interactionresearchstudio/VisionCam_Lasercut_Hanger/Lasercut Hanger.pdf

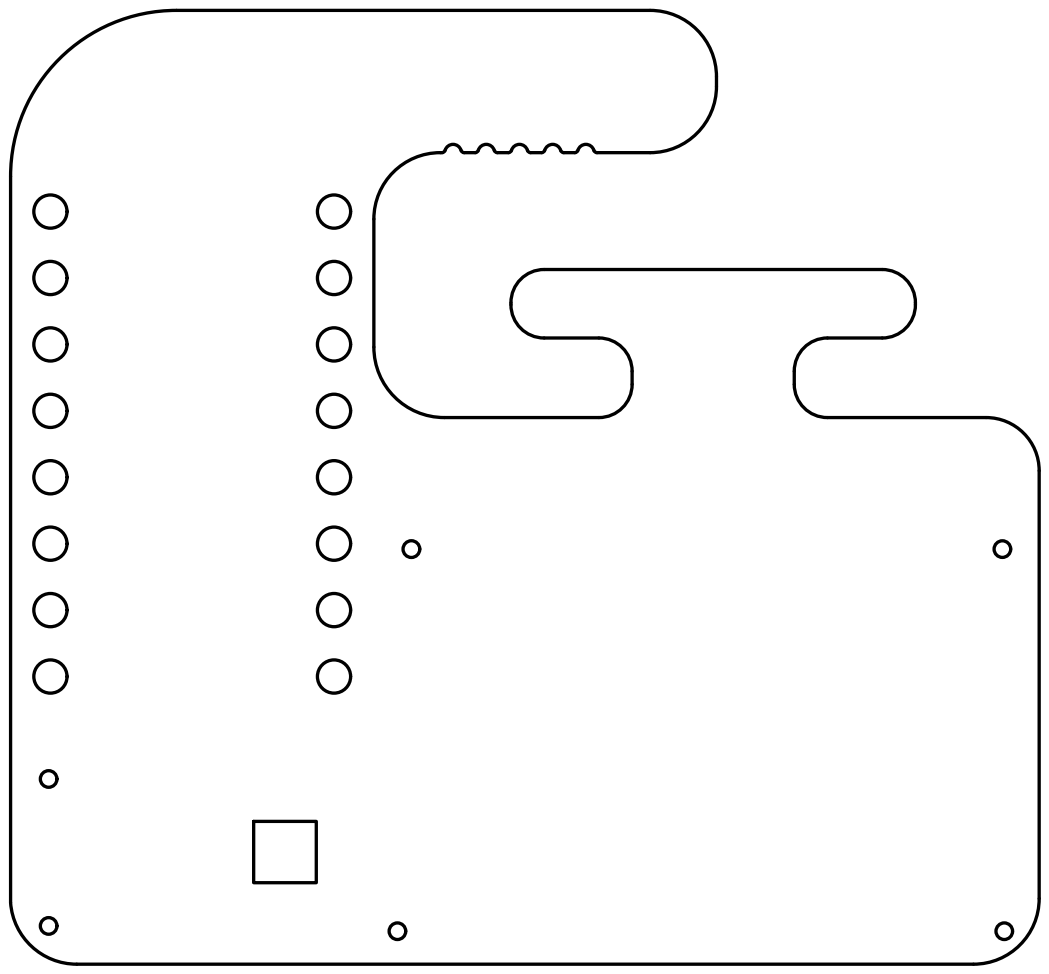
[picture p3: page 1]
