interactionresearchstudio/VisionCam_Lasercut_Hanger/Pi Cam Front Shell.stl

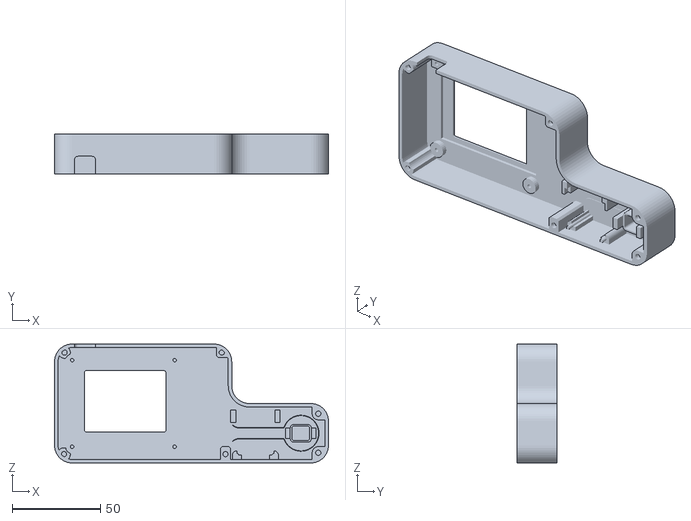
[picture p2: CAD file, 2018-01-03]
Pi Cam Front Shell.stl
155.0 x 22.5 x 67.3
